HENILX0/ESP32_SMART_ROBOT-/Photo & Video/esp32robot.JPG

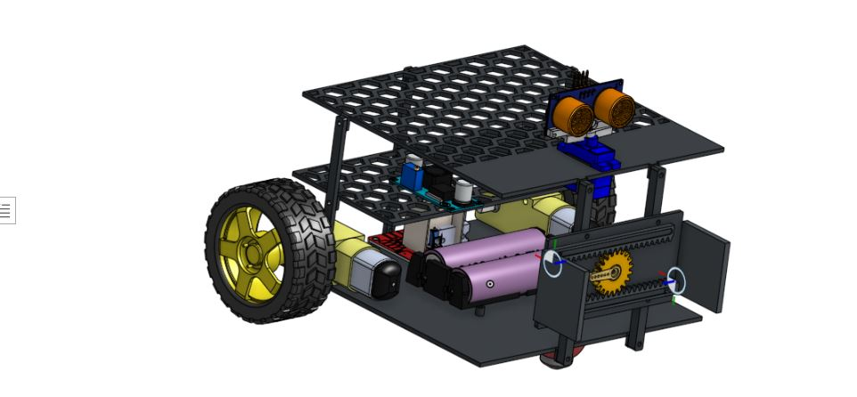
Photo & Video/esp32robot.JPG
