HENILX0/ESP32_SMART_ROBOT-/Photo & Video/gg.JPG

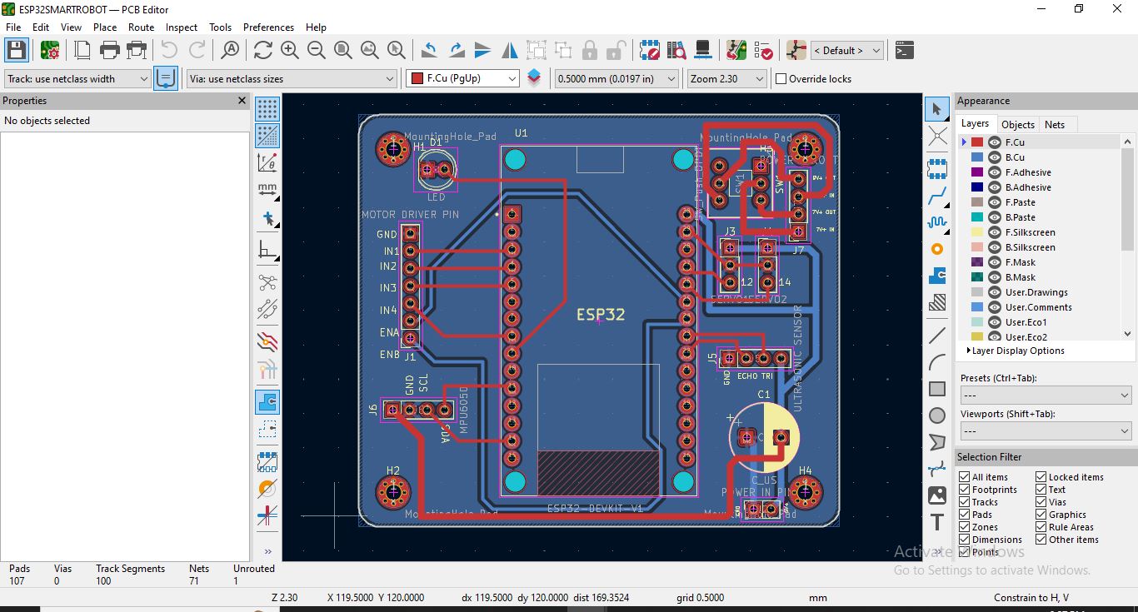
Photo & Video/gg.JPG
