HENILX0/ESP32_SMART_ROBOT-/Photo & Video/esp32robott.JPG

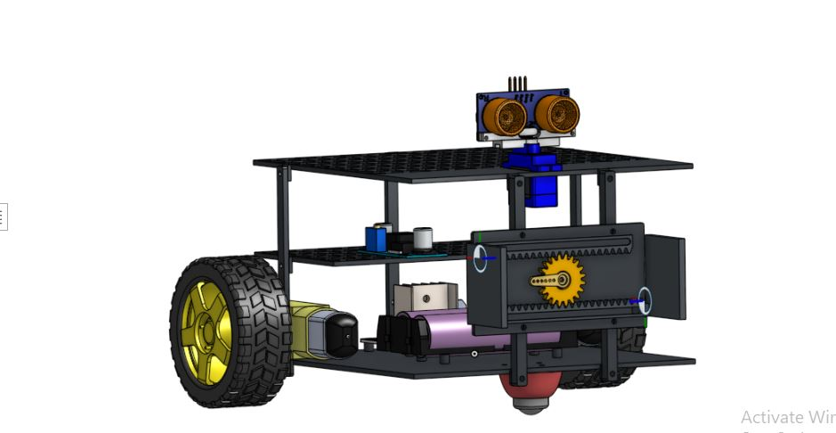
Photo & Video/esp32robott.JPG
