HENILX0/ESP32_SMART_ROBOT-/Photo & Video/gnd pcb.JPG

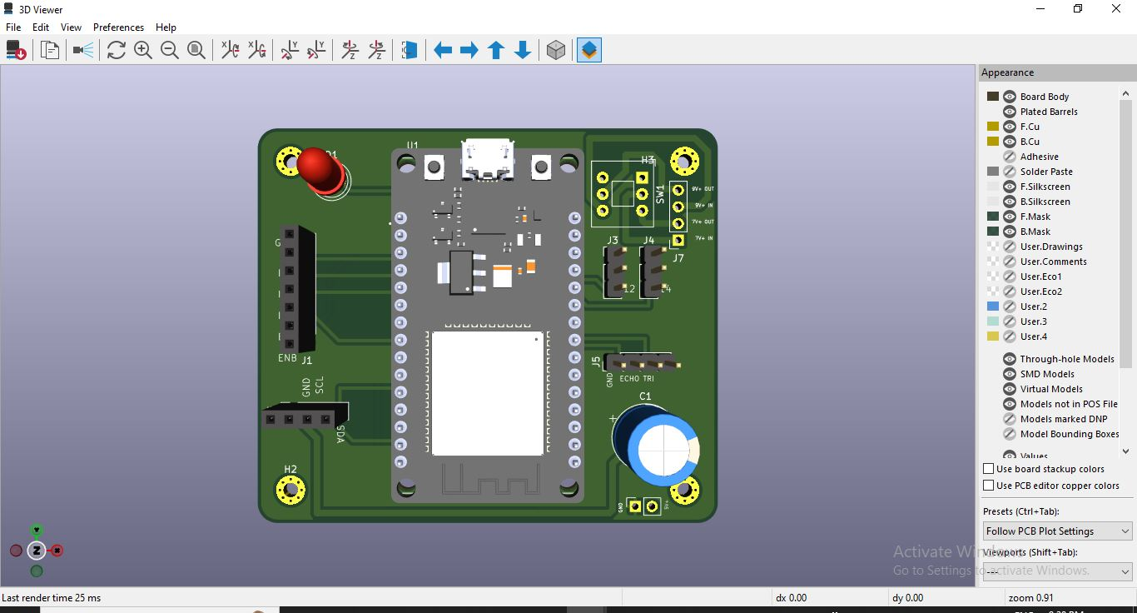
Photo & Video/gnd pcb.JPG
