HENILX0/ESP32_SMART_ROBOT-/Photo & Video/gnf.JPG

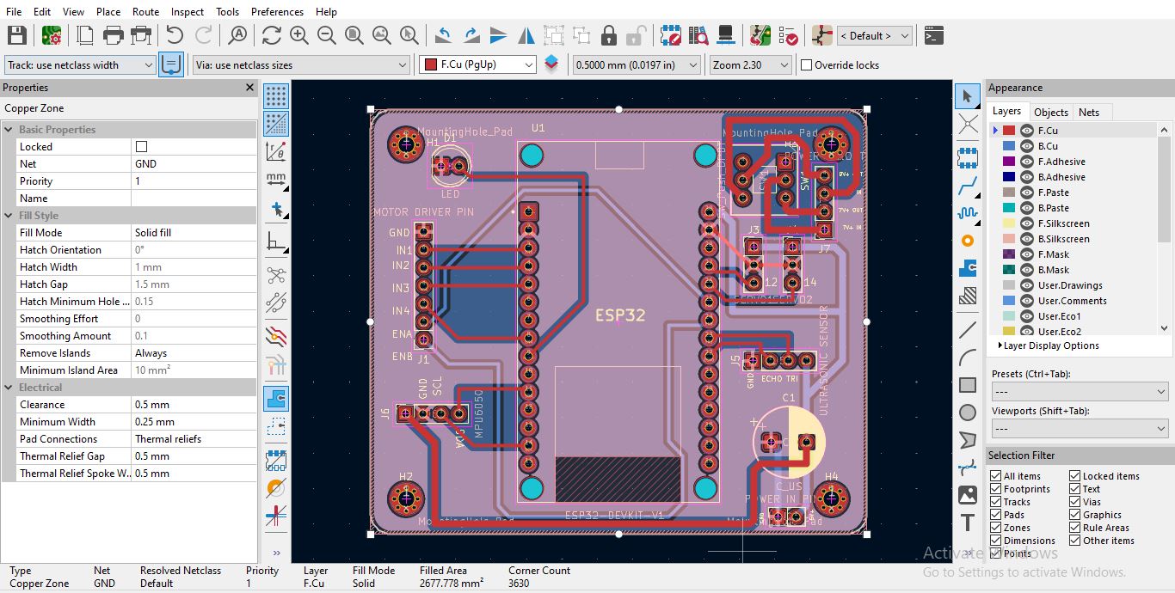
Photo & Video/gnf.JPG
