HENILX0/ESP32_SMART_ROBOT-/Photo & Video/gripper supprot part.JPG

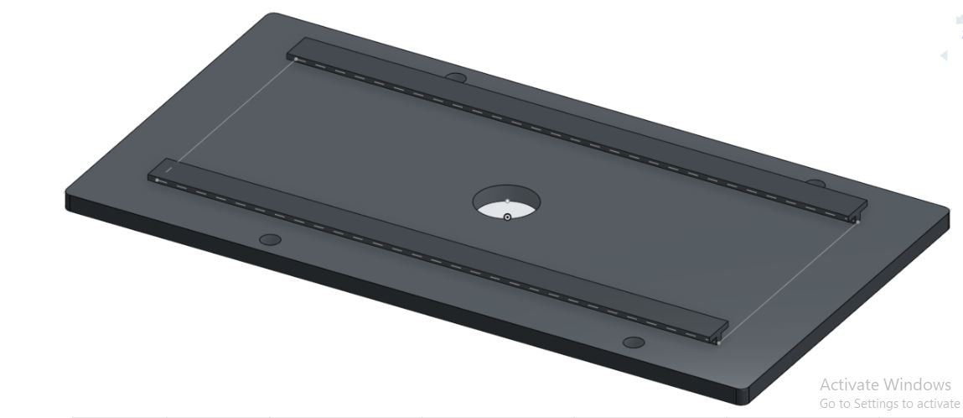
Photo & Video/gripper supprot part.JPG
