HENILX0/ESP32_SMART_ROBOT-/Photo & Video/h part.JPG

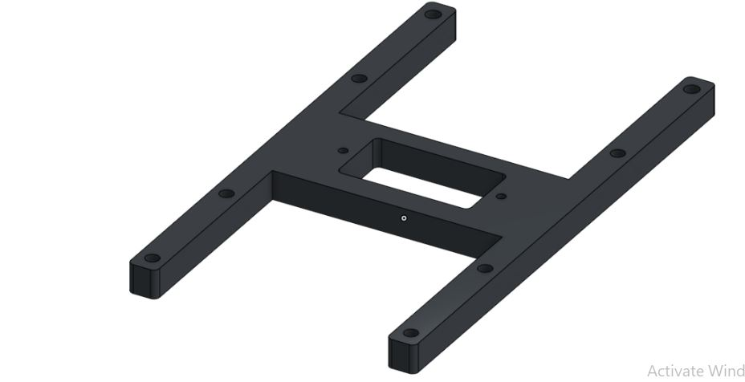
Photo & Video/h part.JPG
