HENILX0/ESP32_SMART_ROBOT-/Photo & Video/middle part.JPG

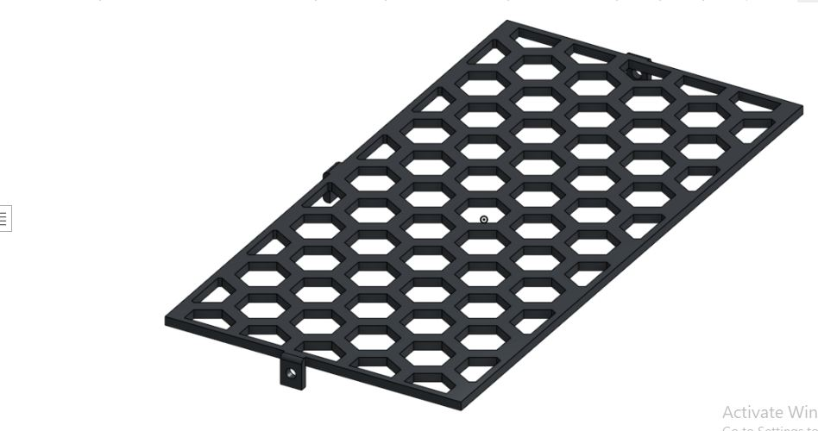
Photo & Video/middle part.JPG
