HENILX0/ESP32_SMART_ROBOT-/Photo & Video/pcb back.JPG

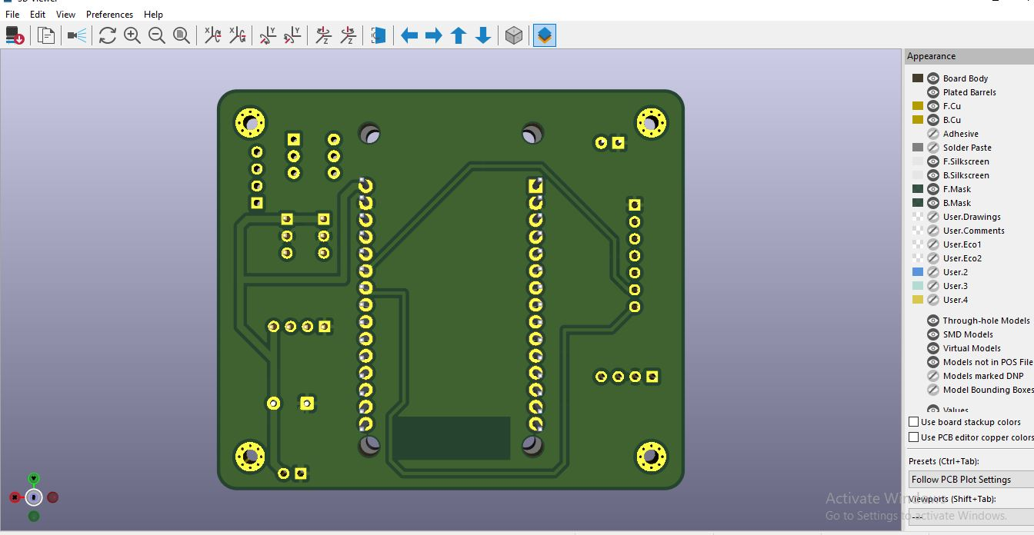
Photo & Video/pcb back.JPG
