HENILX0/ESP32_SMART_ROBOT-/Photo & Video/pinion part.JPG

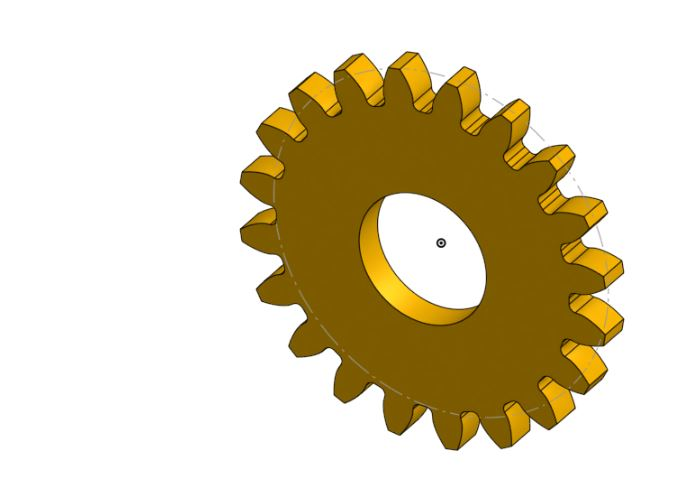
Photo & Video/pinion part.JPG
