HENILX0/ESP32_SMART_ROBOT-/Photo & Video/rack.JPG

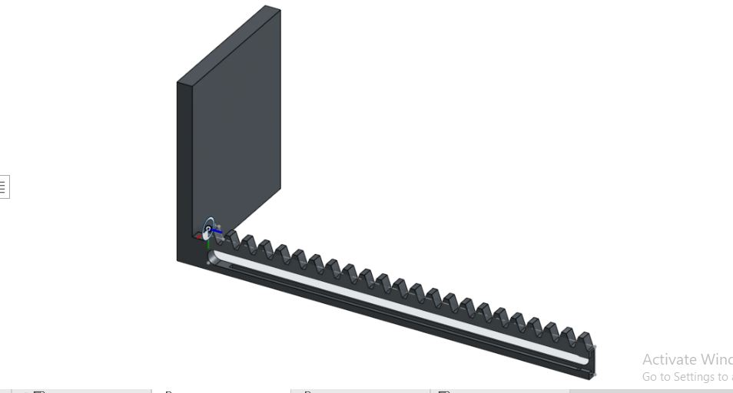
Photo & Video/rack.JPG
