HENILX0/ESP32_SMART_ROBOT-/Photo & Video/robot base.JPG

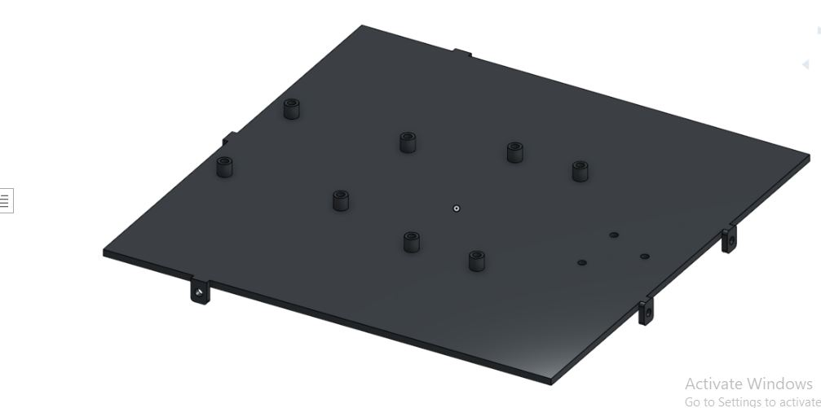
Photo & Video/robot base.JPG
