HENILX0/ESP32_SMART_ROBOT-/Photo & Video/robot joint.JPG

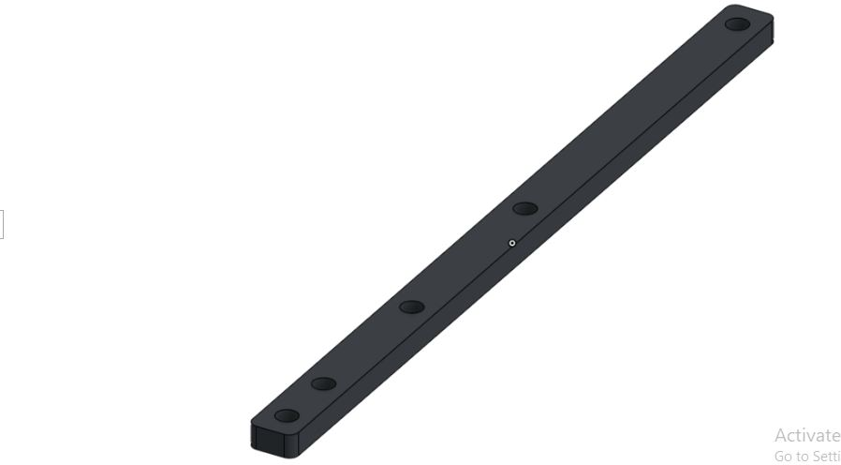
Photo & Video/robot joint.JPG
