HENILX0/ESP32_SMART_ROBOT-/Photo & Video/top part.JPG

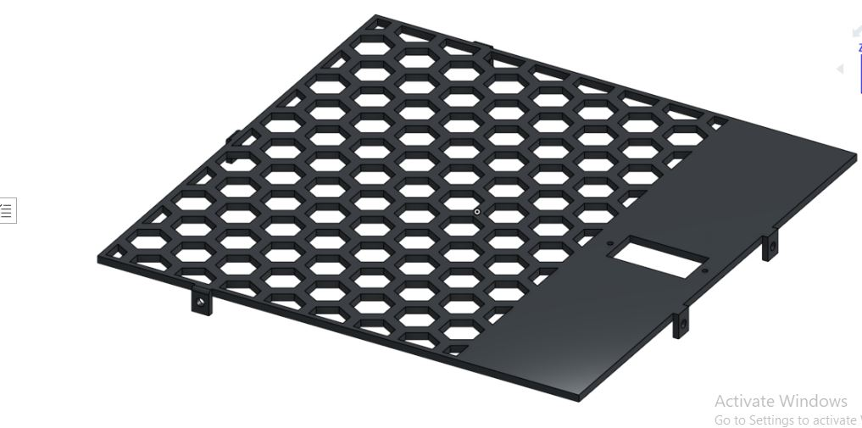
Photo & Video/top part.JPG
