HENILX0/ESP32_SMART_ROBOT-/Photo & Video/ultrasonic servo joint.JPG

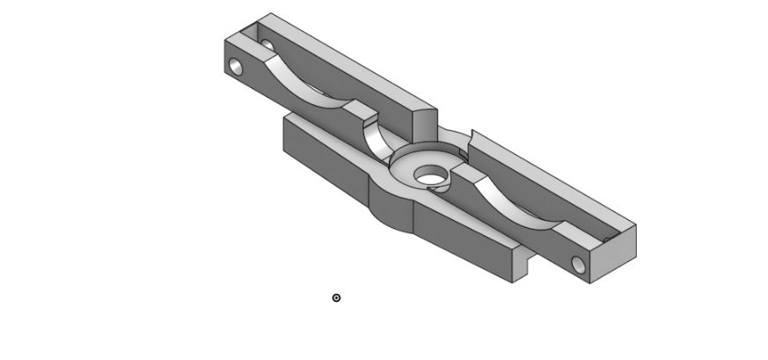
Photo & Video/ultrasonic servo joint.JPG
