HENILX0/ESP32_SMART_ROBOT-/BOM.md

# Bill of Materials 3D PARTS — Stardance Robot

| # | Item | Qty | Gram / Volume | Description | Price (USD) | Source |
|---|---|---|---|---|---|---|
| 1 | TOP PART | 1 | 22.22 $\text{cm}^3$ | Upper section of the robot designated for mounting the servo motor. | $2.68 USD | [Robu 3D Printing Service](https://robu.in/product/3d-printing-service1/) |
| 2 | Servo & Ultrasonic Mount | 1 | 1.07 $\text{cm}^3$ | Custom mount attached to the servo for holding the ultrasonic sensor. | $0.31 USD | [Robu 3D Printing Service](https://robu.in/product/3d-printing-service1/) |
| 3 | Robot Joint | 3 | 1.08 $\text{cm}^3$ (each) | Straight connector links used to join the base, middle, and top sections together using screws. | $1.80 USD | [Robu 3D Printing Service](https://robu.in/product/3d-printing-service1/) |
| 4 | Robot Base | 1 | 39.68 $\text{cm}^3$ | Main chassis base used to mount drive motors, battery, and motor driver. | $2.64 USD | [Robu 3D Printing Service](https://robu.in/product/3d-printing-service1/) |
| 5 | Rack | 2 | 3.63 $\text{cm}^3$ (each) | Linear rack components for the gripper that move back and forth to open and close. | $0.69 USD | [Robu 3D Printing Service](https://robu.in/product/3d-printing-service1/) |
| 6 | Pinion | 1 | 0.58 $\text{cm}^3$ | Gear driven by the servo motor to transfer motion and actuate the gripper racks. | $0.31 USD | [Robu 3D Printing Service](https://robu.in/product/3d-printing-service1/) |
| 7 | Middle Part | 1 | 8.90 $\text{cm}^3$ | Central chassis level designed to house the ESP32 microcontroller and electronics. | $1.41 USD | [Robu 3D Printing Service](https://robu.in/product/3d-printing-service1/) |
| 8 | H Pattern Frame | 1 | 6.98 $\text{cm}^3$ | Structural H-frame mounted at the front linking the base to the top, housing the gripper assembly. | $0.48 USD | [Robu 3D Printing Service](https://robu.in/product/3d-printing-service1/) |
| 9 | Gripper Base | 1 | 8.06 $\text{cm}^3$ | Base platform dedicated to housing the rack-and-pinion gripper mechanism. | $0.38 USD | [Robu 3D Printing Service](https://robu.in/product/3d-printing-service1/) |

---

### Total Grant Required

* **Total Grant Required (USD):** **$11 USD**

# Bill of Materials — Custom ESP32 PCB (JLCPCB)

| # | Item | Qty | Dimensions / Specs | Description | Price (USD) | Source |
|---|---|---|---|---|---|---|
| 1 | Custom ESP32 PCB | 5 pcs | 60×70 mm (2-Layer, FR-4) | Custom designed PCB board for the ESP32 microcontroller , sensor & actuators. | $4.00 USD | [[JLCPCB Online Quote](https://jlcpcb.com/)](https://cart.jlcpcb.com/quote?spm=jlcpcb.Public.2006) |
| 2 | Shipping & Handling | 1 | Standard International Delivery | Shipping charges for delivering the custom manufactured PCB boards. | $24.00 USD | [JLCPCB Delivery](https://jlcpcb.com/) |

---

### Total PCB Grant Required
* **Total Estimated Price (USD):** **$28.00 USD**

# Bill of Materials — Stardance Robot

| # | Item | Qty | Price | Source |
|---|---|---:|---:|---|
| 1 | ESP32 Dev Board | 1 | Already Available | — |
| 2 | BO Motor | 2 | Already Available | — |
| 3 | MPU6050 Sensor | 1 | Already Available | — |
| 4 | Ultrasonic sensor | 1 | Already Available | — |
| 5 | Servo Motor | 2 | Already Available | — |
| 6 | Lithium-ion Battery (3.7V) | 2 | $3.00 USD | [Amazon India](https://www.amazon.in/Flysmart-Capacity-Rechargeable-Batteries-Bluetooth/dp/B0DTTL1SZ4/) |
| 7 | 2S BMS Module | 1 | $2.00 USD | [Amazon India](https://www.amazon.in/JIVITH-Lithium-Battery-Protection-Module/dp/B0HGMHS17H/) |
| 8 | M2.5 Screw & Nuts Assortment Kit | 1 | $3.50 USD | [Amazon India](https://www.amazon.in/Metric-Stainless-Steel-Phillips-Washer/dp/B07GKWFQSV/) |
| 9 | Wheel BO MOTOR | 2 | Already Available | — |
| 10 | Caster Wheel | 1 | Already Available | — |
| 11 | Wire | As required | Already Available | — |
| 12 | LM2596 DC-DC Buck Converter | 1 | Already Available | — |
| 13 | DPDT Switch | 1 | Already Available | — |
| 14 | Motor Driver | 1 | Already Available | — |
| 15 | Dual Battery Holder | 1 | Already Available | — |
| 16 | Electronic components |As required | Already Available | — |

---

### Total Components Grant Required
* **Total Estimated Price (USD):** **$8.50 USD**

----

### Total Components Grant Required
* **Total Estimated Price (USD):** **$47.50 USD**
