HENILX0/ESP32_SMART_ROBOT-/ROBOT CAD/robot base.stl

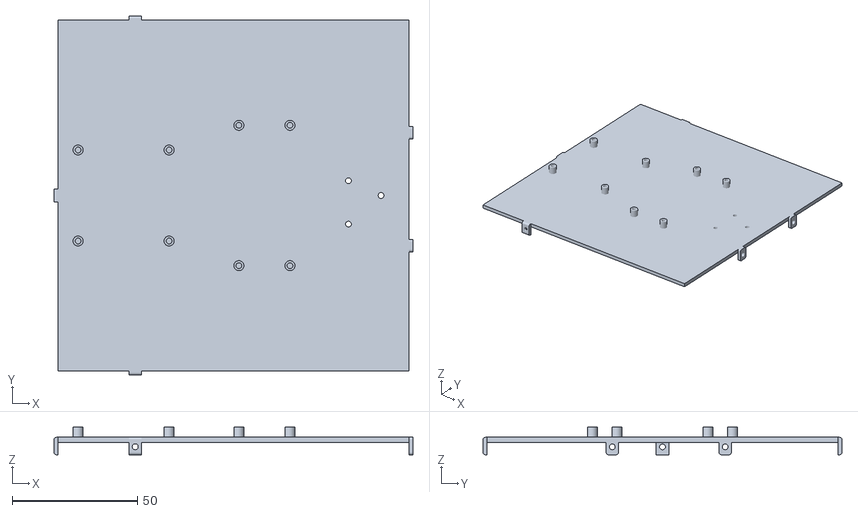
[picture p16: CAD file, 2026-09-21]
ROBOT CAD/robot base.stl
143.2 x 143.2 x 11.0
