HENILX0/ESP32_SMART_ROBOT-/ROBOT CAD/top part of robot.stl

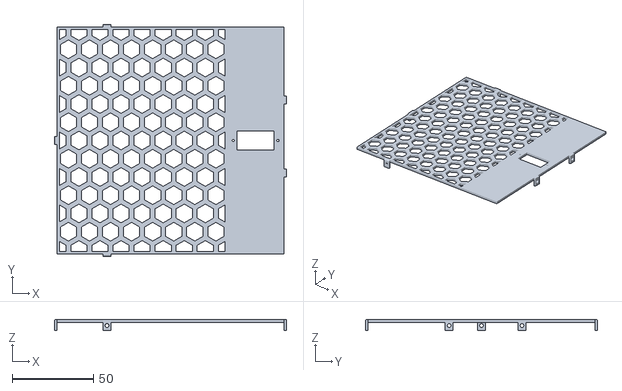
[picture p17: CAD file, 2026-09-21]
ROBOT CAD/top part of robot.stl
143.2 x 143.2 x 7.00
