HENILX0/ESP32_SMART_ROBOT-/ROBOT CAD/gripper support , base and top connector part.stl

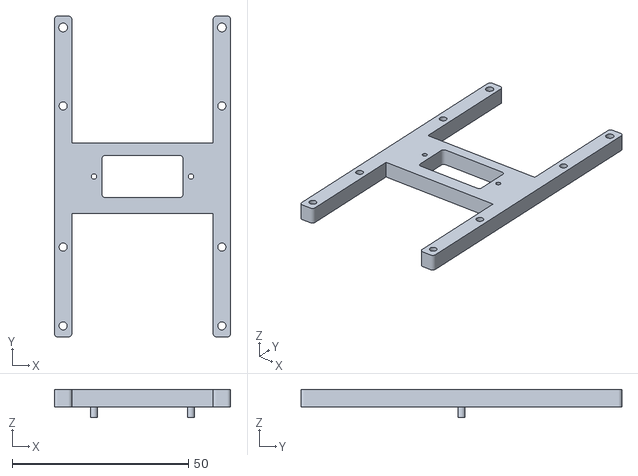
[picture p18: CAD file, 2026-09-21]
ROBOT CAD/gripper support , base and top connector part.stl
50.0 x 91.0 x 8.00
