HENILX0/ESP32_SMART_ROBOT-/ROBOT CAD/pinion1.stl

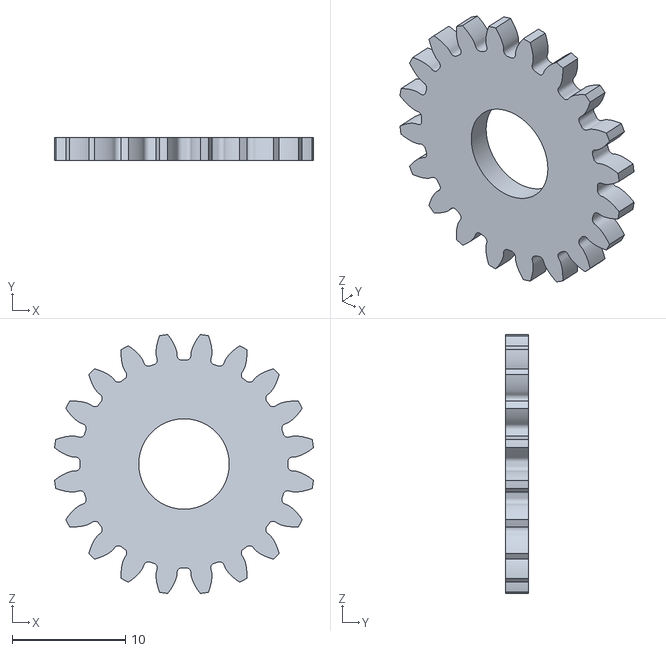
[picture p19: CAD file, 2026-09-21]
ROBOT CAD/pinion1.stl
22.9 x 2.00 x 22.9
