HENILX0/ESP32_SMART_ROBOT-/ROBOT CAD/middle part of robot.stl

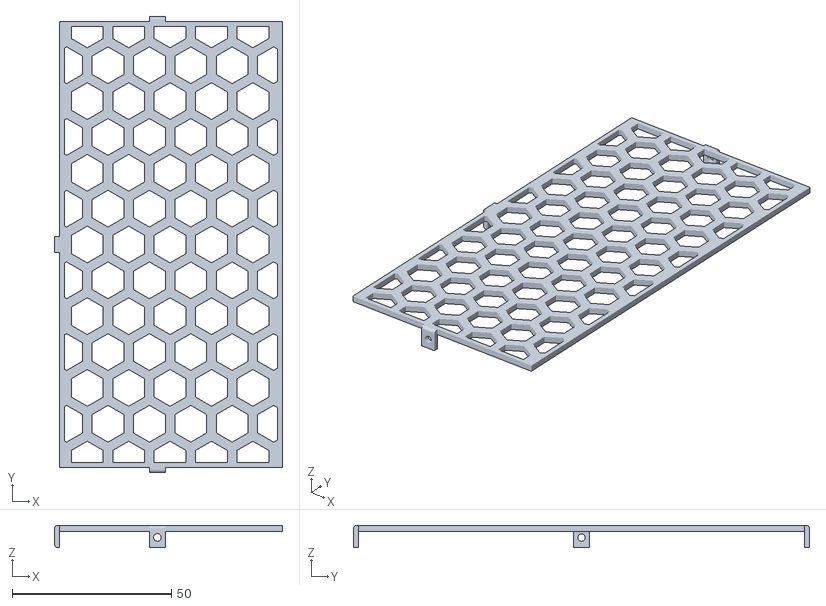
[picture p20: CAD file, 2026-09-21]
ROBOT CAD/middle part of robot.stl
71.6 x 143.2 x 7.00
