HENILX0/ESP32_SMART_ROBOT-/ROBOT CAD/rack2.stl

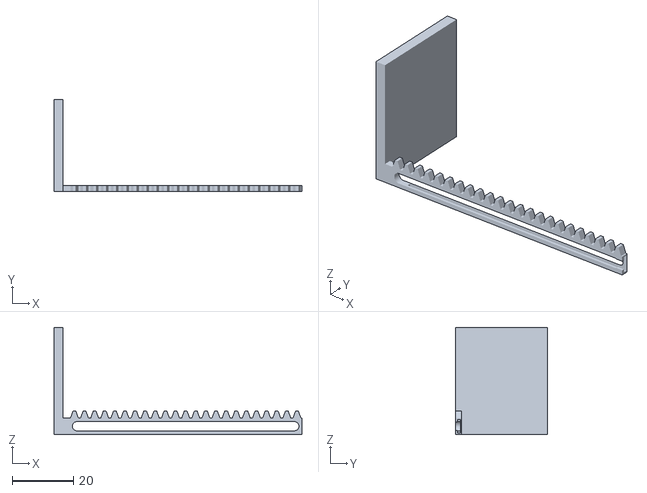
[picture p21: CAD file, 2026-09-21]
ROBOT CAD/rack2.stl
80.9 x 30.0 x 35.0
