HENILX0/ESP32_SMART_ROBOT-/ROBOT CAD/Servo-UltraSonic_Sensor_Mount.stl

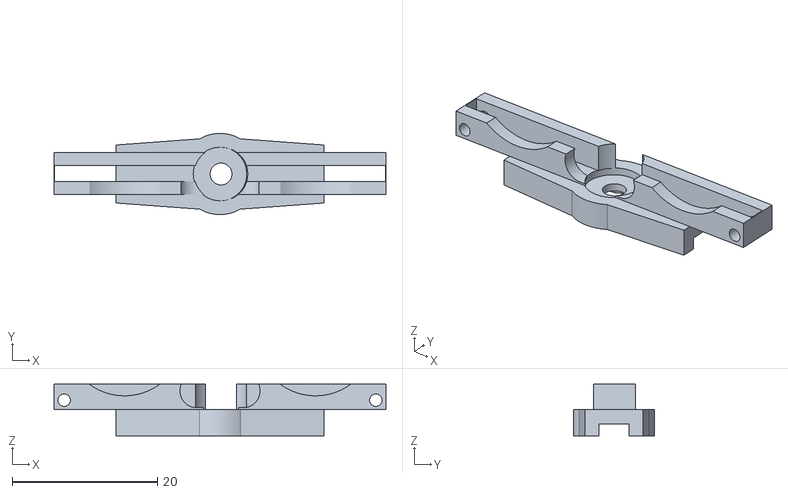
[picture p22: CAD file, 2026-09-21]
ROBOT CAD/Servo-UltraSonic_Sensor_Mount.stl
45.6 x 11.2 x 7.10
