HENILX0/ESP32_SMART_ROBOT-/ROBOT CAD/griper rack and pinion part.stl

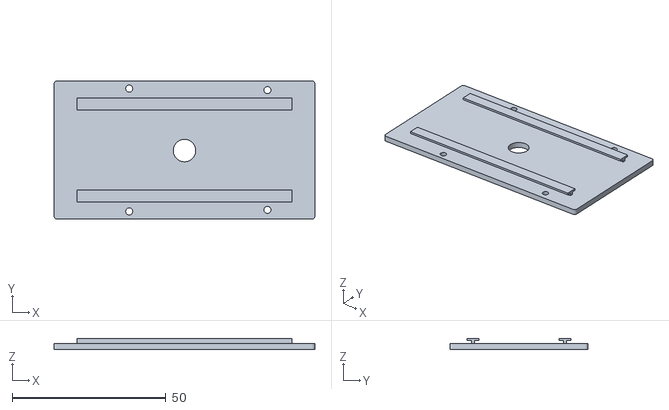
[picture p23: CAD file, 2026-09-21]
ROBOT CAD/griper rack and pinion part.stl
85.0 x 45.0 x 3.70
