HENILX0/ESP32_SMART_ROBOT-/ROBOT CAD/robot joint.stl

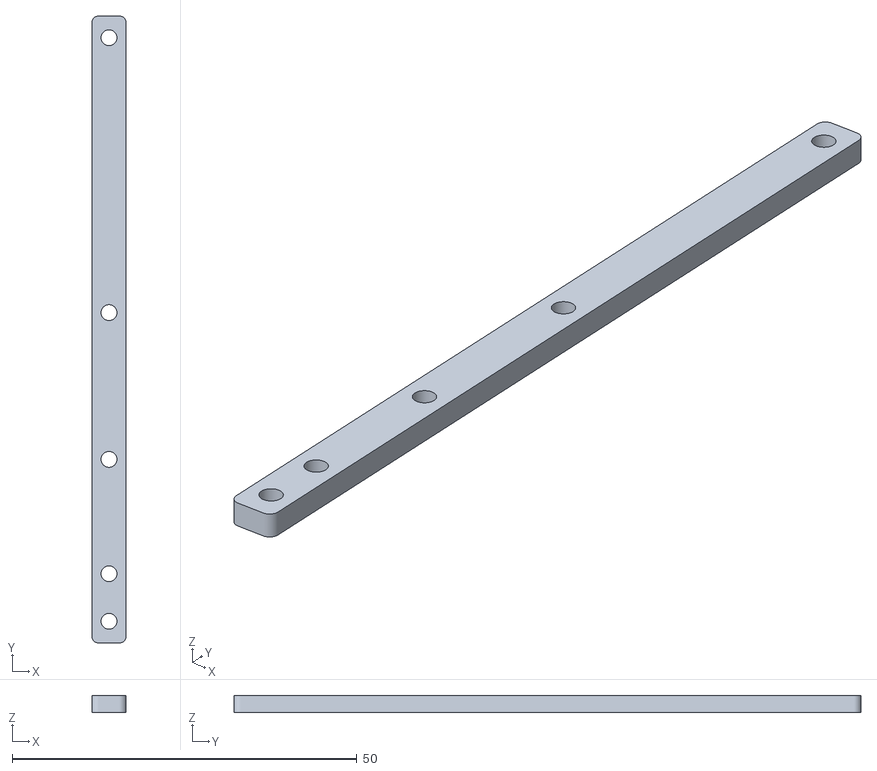
[picture p24: CAD file, 2026-09-21]
ROBOT CAD/robot joint.stl
5.00 x 91.0 x 2.50
