HENILX0/ESP32_SMART_ROBOT-/(commit log)

2026-09-21 Create CAD
2026-09-22 Update and rename BOM.csv to BOM.md
    [BOM.csv]
